eltonyi1/Smart_Water_Dispenser/(list of files, drawings)

Other design files:
Hardware/PCB/ProPrj_大创集成版（原理图）_2025-12-10.epro
