eltonyi1/Smart_Water_Dispenser/water_dispenser3/water_dispenser3.ioc

Mcu.UserName=STM32F103C8Tx
PA10.Signal=USART1_RX
PA13.Signal=SYS_JTMS-SWDIO
PA14.Signal=SYS_JTCK-SWCLK
PA2.Signal=USART2_TX
PA3.Signal=USART2_RX
PA6.Signal=GPIO_Output
PA7.Signal=GPIO_Output
PA9.Signal=USART1_TX
PB0.Signal=S_TIM3_CH3
PB1.Signal=GPIO_Output
PD0-OSC_IN.Signal=RCC_OSC_IN
PD1-OSC_OUT.Signal=RCC_OSC_OUT
