eltonyi1/Smart_Water_Dispenser/Tools/Algo_Simulation/find_threshold5.py

from dataclasses import dataclass
from typing import List, Optional, Dict

MIN_I, MAX_I = 40, 170  # 有效区间

@dataclass
class Peak:
    idx: int
    amp: int
    left: int
    right: int
    prominence: float
    role: str = "unknown"


def smooth(signal, w=5):
    if w <= 1:
        return signal[:]
    out = []
    half = w // 2
    for i in range(len(signal)):
        s = 0
        c = 0
        for j in range(i-half, i+half+1):
            if 0 <= j < len(signal):
                s += signal[j]; c += 1
        out.append(s / c)
    return out

def detect_peaks(sig, base_thresh):
    peaks = []
    n = len(sig)
    for i in range(1, n-1):
        if sig[i] > sig[i-1] and sig[i] >= sig[i+1] and sig[i] >= base_thresh:
            # temporary single-point peak; refine bounds
            left = i
            while left > 0 and sig[left-1] <= sig[left] and sig[left-1] > 0:
                left -= 1
                if sig[left] < base_thresh * 0.4:
                    break
            right = i
            while right < n-1 and sig[right+1] <= sig[right] and sig[right+1] > 0:
                right += 1
                if sig[right] < base_thresh * 0.4:
                    break
            # valley-based prominence (simplified)
            valley_left = min(sig[max(0, left-2):left+1]) if left > 0 else sig[left]
            valley_right = min(sig[right:right+3]) if right < n-1 else sig[right]
            prom = max(sig[i] - valley_left, sig[i] - valley_right)
            
            peaks.append(Peak(idx=i, amp=int(sig[i]), left=left, right=right,
                              prominence=prom))
    return peaks

def merge_close_peaks(peaks: List[Peak], min_prom: float):
    if not peaks:
        return peaks
    peaks.sort(key=lambda p: p.idx)
    merged = []
    current = peaks[0]
    for p in peaks[1:]:
        # overlap or near
        if p.idx - current.idx <= 3 and (min(p.amp, current.amp) > 0.7 * max(p.amp, current.amp)):
            # merge by choosing higher
            if p.amp > current.amp:
                current.idx = p.idx
                current.amp = p.amp
            current.left = min(current.left, p.left)
            current.right = max(current.right, p.right)
            current.prominence = max(current.prominence, p.prominence)
        else:
            if current.prominence >= min_prom:
                merged.append(current)
            current = p
    if current.prominence >= min_prom:
        merged.append(current)
    return merged

def classify_peaks(peaks: List[Peak], valid_len: int):
    if not peaks:
        return None, None
    # sort
    peaks.sort(key=lambda p: p.idx)
    if len(peaks) == 1:
        p = peaks[0]
        # midpoint heuristic
        if p.idx > valid_len * 0.55:
            p.role = "liquid"
            return None, p
        else:
            p.role = "edge"
            return p, None

    # 多峰情况
    # 先假定最左峰是边沿
    edge = peaks[0]
    edge.role = "edge"

    if len(peaks) == 2:
        liquid = peaks[-1]
        liquid.role = "liquid"
        return edge, liquid

    # 使用局部窗口长度(valid_len)而非全局MAX_I来划分右侧候选区
    # “右侧区域”取从edge向右40%窗口长度处开始
    right_idx = int(edge.idx + (valid_len - edge.idx) * 0.4)
    right_peaks = [pk for pk in peaks[1:] if pk.idx > right_idx]

    # 兜底：若右侧候选为空，直接用最右峰作为液面峰，防止max([])报错
    rightmost = peaks[-1]
    if not right_peaks:
        liquid = rightmost
    else:
        max_right_peak = max(right_peaks, key=lambda pk: pk.amp)
        liquid = max_right_peak

    liquid.role = "liquid"

    for pk in peaks:
        if pk.role == "unknown":
            pk.role = "interf"
    return edge, liquid

def compute_thresholds(raw):
    sub = raw[MIN_I:MAX_I+1]
    sm = smooth(sub, w=5)

    base_thresh = 250

    peaks = detect_peaks(sm, base_thresh*0.9)  # 稍微放宽初捕捉
    min_prom = 60
    peaks = merge_close_peaks(peaks, min_prom=min_prom)

    if len(peaks)<=1:
        return {
            "edge_idx": None, "liquid_idx": None,
            "t1": 400, "x": 60,
            "t2": 250, "y": 152,
            "peaks": [], 
            "notes": "No container"
        }

    
    edge, liquid = classify_peaks(peaks, len(sub))

    # index restore
    def restore_idx(local_idx): 
        return local_idx + MIN_I

    # Interference peaks
    interf_peaks = []
    if edge and liquid:
        for p in peaks:
            if p.role == "interf" and edge.idx < p.idx < liquid.idx:
                interf_peaks.append(p)

    # Determine x and t1
    edge_extension = False
    interf_peaks_right = []
    edge_cluster_right = edge.right
    edge_cluster_amp = edge.amp

    if interf_peaks:
        interf_max = max(interf_peaks, key=lambda p: p.amp)
        if interf_max.amp >= edge.amp:
            edge_extension = True
            edge_cluster_right = interf_max.right
            edge_cluster_amp = interf_max.amp
            interf_peaks_right = [p for p in interf_peaks if p.idx > interf_max.idx]
        
        
    x = restore_idx(min(edge_cluster_right + 3, liquid.idx - 3))
    t1 = edge_cluster_amp + 0.3*edge_cluster_amp

    # Determine y
    if not interf_peaks or not interf_peaks_right:
        y_local = 152
    else:
        y_local = max(p.right for p in interf_peaks)
        consecutive = 0
        interf_right = y_local
        for i in range(interf_right+1, liquid.idx):
            if sm[i] < 250:
                consecutive += 1
                if consecutive >= 3:
                    y_local = i
                    break
            else:
                consecutive = 0
    
    y = restore_idx(min(y_local, liquid.idx - 2))

    # Determine t2
    if edge_extension:
        if interf_peaks_right:
            int_max_amp = max(p.amp for p in interf_peaks_right)
        else:
            int_max_amp = 250
    else:
        if interf_peaks:
            int_max_amp = max(p.amp for p in interf_peaks)
        else:
            int_max_amp = 250
    t2 = int_max_amp + 0.3*int_max_amp


    # Adjust ordering
    if y < x:
        m = y
        y = x
        x = m
    elif y == x:
        y += 1

    result = {
        "edge_idx": restore_idx(edge.idx) if edge and edge.role == "edge" else None,
        "liquid_idx": restore_idx(liquid.idx) if liquid else None,
        "t1": int(round(t1)),
        "x": x,
        "t2": int(round(t2)),
        "y": y,
        "peaks": [
            {
                "idx": restore_idx(p.idx),
                "amp": p.amp,
                "prom": round(p.prominence,2),
                "left": restore_idx(p.left),
                "right": restore_idx(p.right),
                "role": p.role
            } for p in peaks
        ],
    }
    return result

# 示例调用
if __name__ == "__main__":
    # data = [0,22,101,164,106,154,961,2650,4075,4131,3324,2569,2036,1587,1230,984,765,566,480,755,1447,
    #            1954,1816,1406,1093,875,685,555,451,341,274,212,150,138,125,100,93,62,18,21,45,46,31,27,20,
    #            24,10,17,16,2,26,5,40,20,31,7,22,38,9,46,11,33,2,32,20,21,7,43,20,53,57,25,18,5,29,21,47,28,
    #            19,6,0,0,0,0,0,1,0,0,0,10,46,41,91,191,320,575,828,1033,1306,1550,1647,1644,1541,1342,1116,
    #            914,751,622,512,416,339,294,267,258,267,237,194,203,189,154,134,116,68,31,55,87,65,33,66,81,
    #            58,58,47,6,5,4,35,48,39,52,42,21,21,18,18,14,10,34,32,47,66,191,320,575,828,1033,1306,1550,
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
    out = compute_thresholds(data)
    print(out)
