eltonyi1/Smart_Water_Dispenser/(commit log)

2026-01-12 Initial commit: STM32 water dispenser project with algorithm tools
    [ProPrj_大创集成版（原理图）_2025-12-10.epro]
2026-01-12 更新 README，添加项目成员和贡献者信息
2026-01-12 修正 README 中的拼写错误
2026-01-12 修正拼写错误
