eltonyi1/Smart_Water_Dispenser/(notices)

Notices in the files:
water_dispenser3/Core/Src/main.c:
Copyright (c) 2025 STMicroelectronics.
All rights reserved.
This software is licensed under terms that can be found in the LICENSE file
